Dongwoo923/Project-CustomRemote/SourceCode/MyRemote.ioc

Mcu.UserName=STM32F411RETx
PA0-WKUP.Signal=ADCx_IN0
PA1.Signal=ADCx_IN1
PA2.Signal=USART2_TX
PA3.Signal=USART2_RX
PA4.Signal=GPXTI4
PA5.Signal=GPXTI5
PA6.Signal=S_TIM3_CH1
PB8.Signal=I2C1_SCL
PB9.Signal=I2C1_SDA
